prakashlab/inkwell/README.md

# Inkwell
An electricity-free blood-smearing device

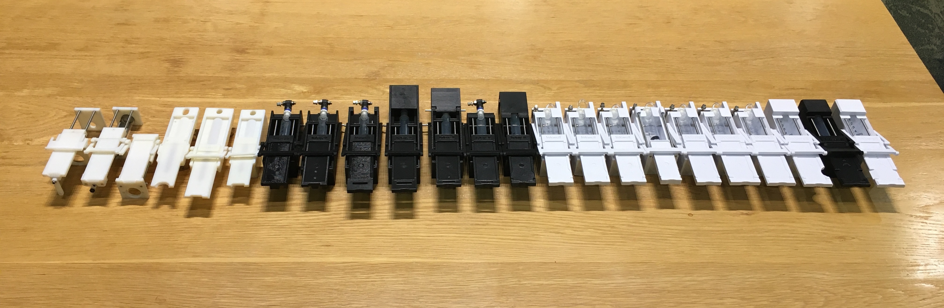
[picture p1: Previous_versions/Family_History_Photos/Inkwell_History_v0.1-v2.8.2.jpeg]
Inkwell History from v0.1 to v2.8.2


The CAD files for the latest version of Inkwell can be found under the Inkwell_v*** folder in the parent directory. All parts should be printed on an FDM machine without support material and oriented as shown in the accompanying screenshots.
