prakashlab/inkwell/Inkwell_v2.9.5/3D_printing_files/Correct Parts Orientation Front.png

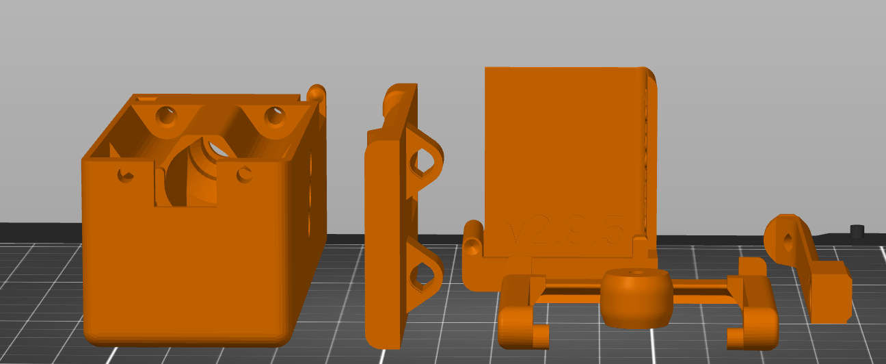
Inkwell_v2.9.5/3D_printing_files/Correct Parts Orientation Front.png
