prakashlab/inkwell/Inkwell_v2.9.5/3D_printing_files/Individual_STL_Parts/Main Body.stl

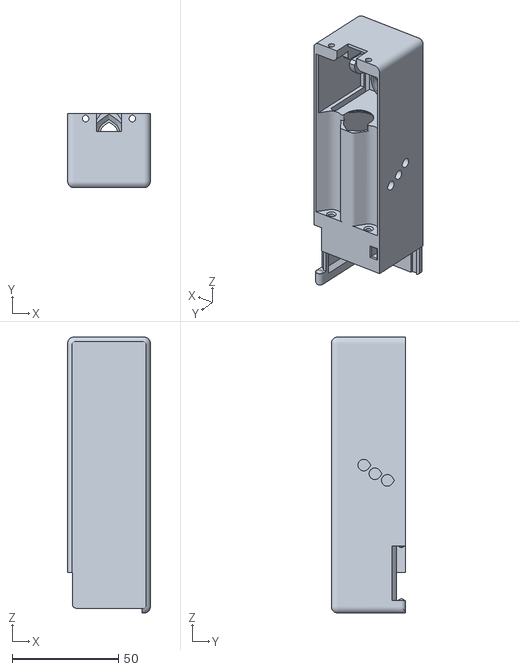
[picture p5: CAD file, 2025-02-18]
Inkwell_v2.9.5/3D_printing_files/Individual_STL_Parts/Main Body.stl
39.0 x 35.0 x 130.0
