prakashlab/inkwell/Inkwell_v2.9.5/3D_printing_files/3MF_and_G-code_files_for_Prusa_i3_MK3S/1x Inkwell v2.9.5.3mf

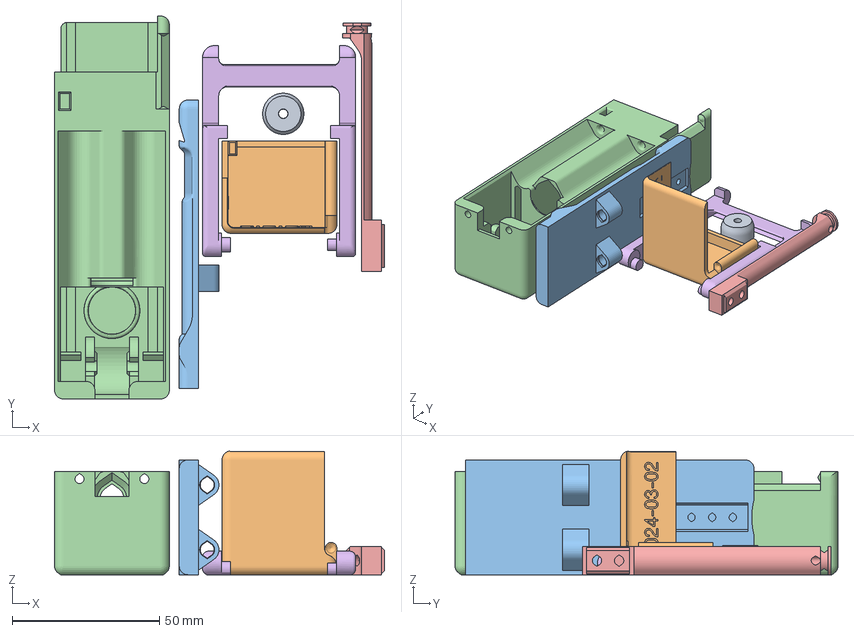
[picture p6: CAD file, 2025-02-18]
Inkwell_v2.9.5/3D_printing_files/3MF_and_G-code_files_for_Prusa_i3_MK3S/1x Inkwell v2.9.5.3mf
112.0 x 130.0 x 41.9 mm
Spool.stl
Back Cover.stl
Carriage.stl
Main Body.stl
Plunger v2.8.2.stl
Spreader Holder.stl
