prakashlab/inkwell/Inkwell_v2.9.5/3D_printing_files/Individual_STL_Parts/Plunger.stl

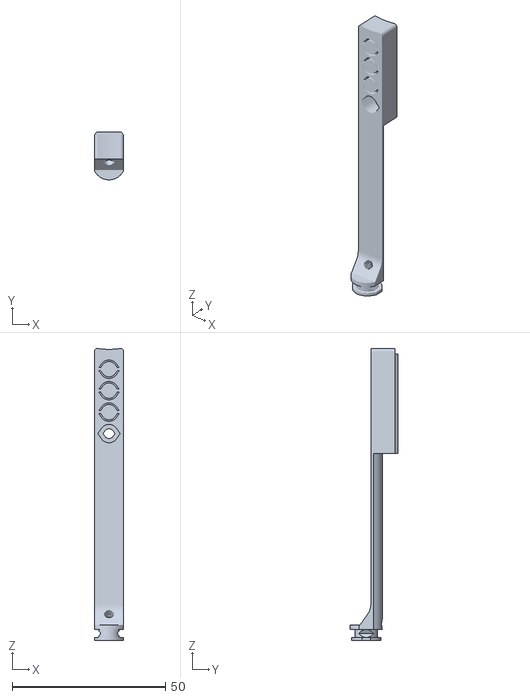
[picture p7: CAD file, 2025-02-18]
Inkwell_v2.9.5/3D_printing_files/Individual_STL_Parts/Plunger.stl
9.60 x 15.5 x 95.1
