prakashlab/inkwell/Inkwell_v2.9.5/3D_printing_files/Individual_STL_Parts/Carriage.stl

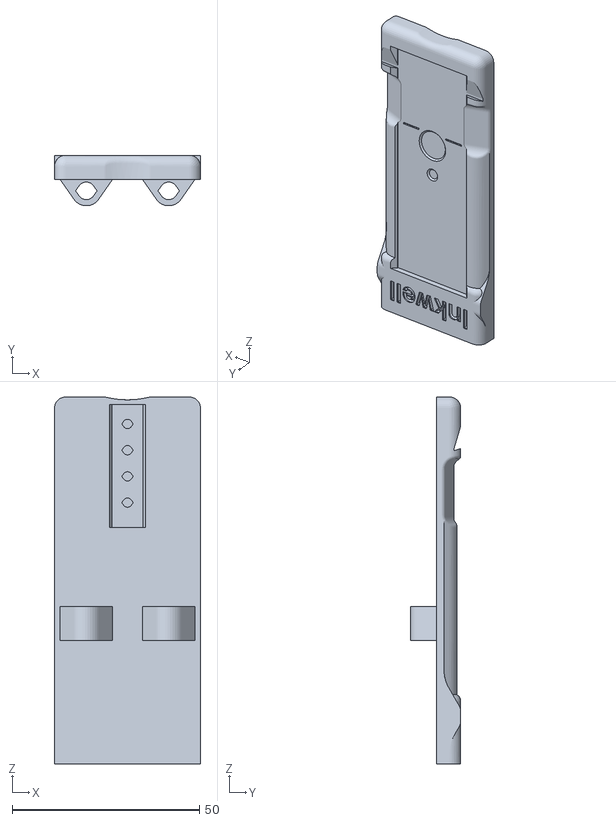
[picture p8: CAD file, 2025-02-18]
Inkwell_v2.9.5/3D_printing_files/Individual_STL_Parts/Carriage.stl
39.0 x 13.5 x 98.0
