prakashlab/inkwell/Inkwell_v2.9.5/3D_printing_files/Individual_STL_Parts/Spool.stl

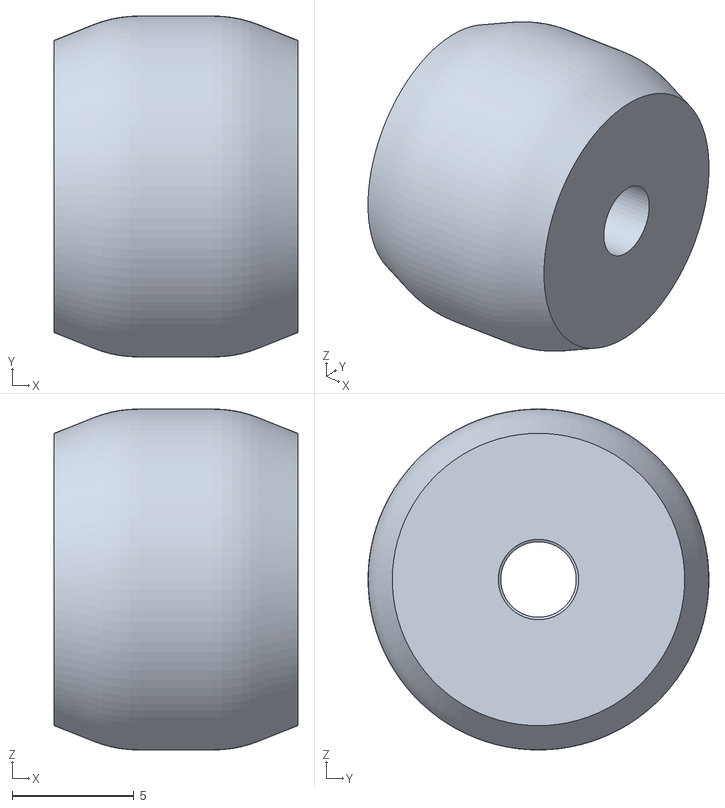
[picture p9: CAD file, 2025-02-18]
Inkwell_v2.9.5/3D_printing_files/Individual_STL_Parts/Spool.stl
10.0 x 14.0 x 14.0
