prakashlab/inkwell/Inkwell_v2.9.5/3D_printing_files/Individual_STL_Parts/Back Cover.stl

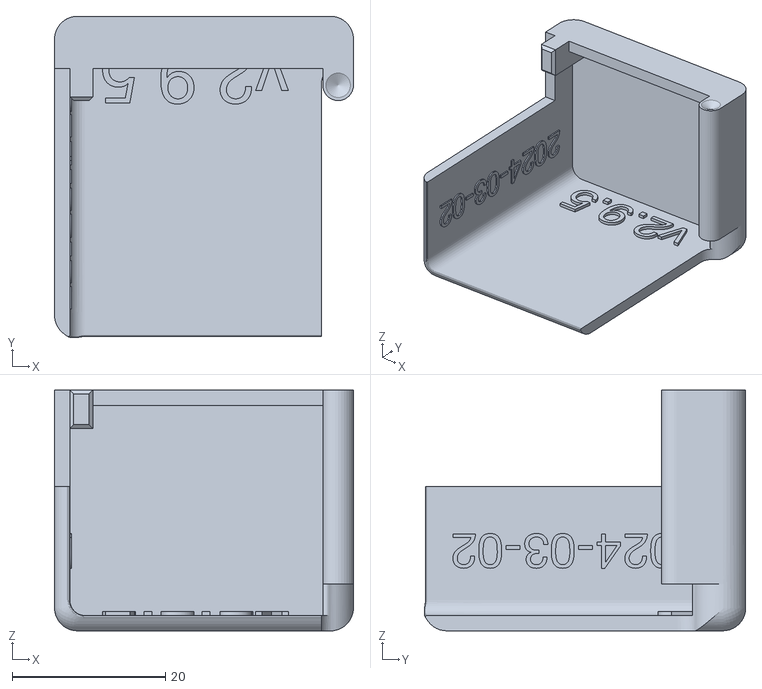
[picture p10: CAD file, 2025-02-18]
Inkwell_v2.9.5/3D_printing_files/Individual_STL_Parts/Back Cover.stl
39.0 x 41.9 x 31.4
