prakashlab/inkwell/Inkwell_v2.9.5/3D_printing_files/Individual_STL_Parts/Spreader Holder.stl

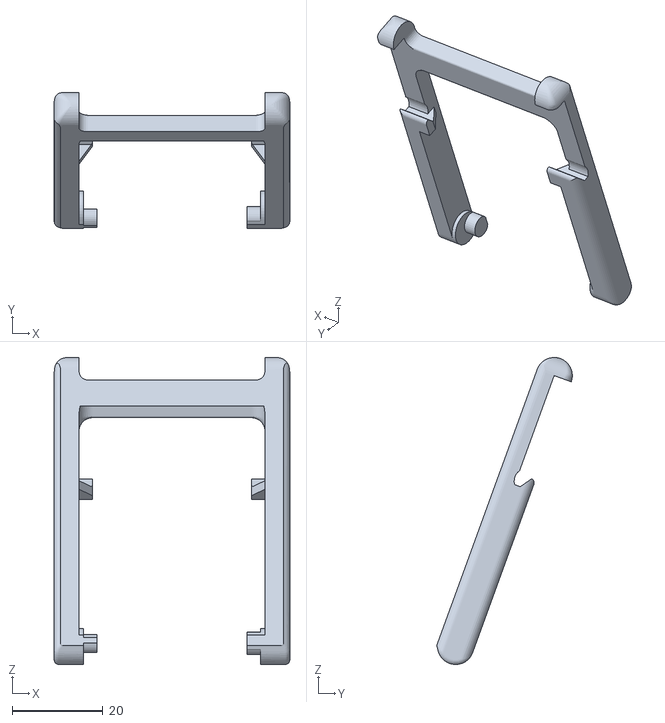
[picture p11: CAD file, 2025-02-18]
Inkwell_v2.9.5/3D_printing_files/Individual_STL_Parts/Spreader Holder.stl
52.0 x 29.9 x 67.8
