prakashlab/inkwell/Previous_versions/Inkwell_v0.3/Main Body.stl

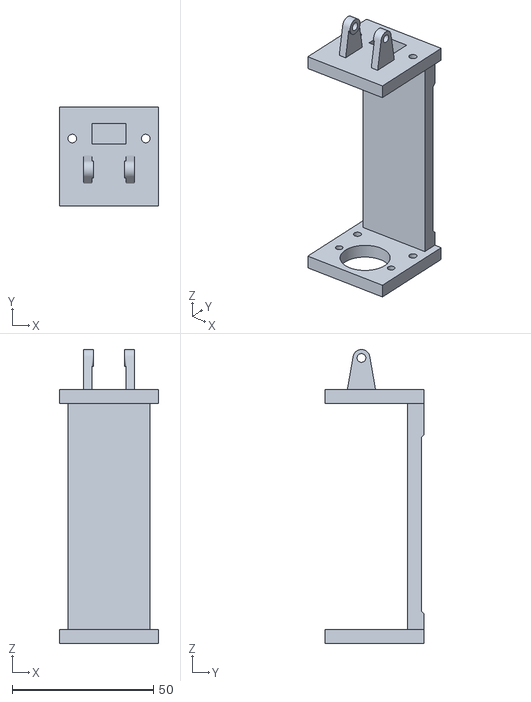
[picture p12: CAD file, 2025-02-18, an earlier design]
Previous_versions/Inkwell_v0.3/Main Body.stl
35.0 x 35.2 x 104.2
