prakashlab/inkwell/Previous_versions/Inkwell_v2.3.1/Main Body.stl

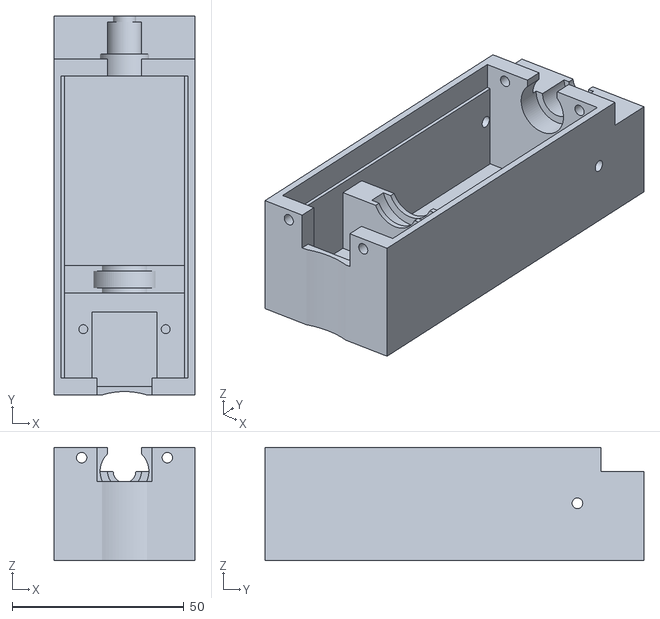
[picture p13: CAD file, 2023-05-05, an earlier design]
Previous_versions/Inkwell_v2.3.1/Main Body.stl
41.0 x 110.5 x 33.0
