prakashlab/inkwell/Previous_versions/Inkwell_v2.7.1/Main Body.stl

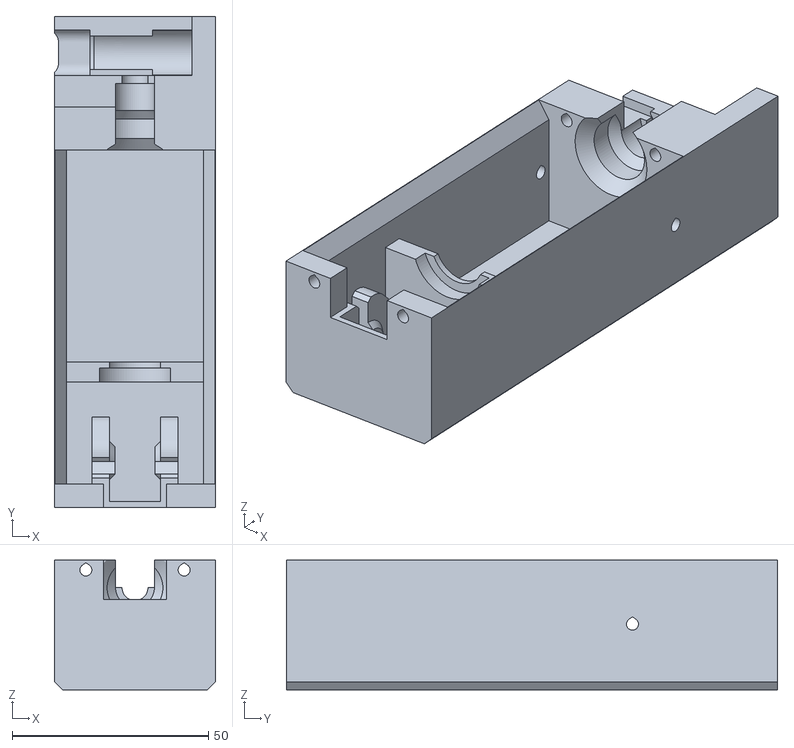
[picture p14: CAD file, 2023-05-05, an earlier design]
Previous_versions/Inkwell_v2.7.1/Main Body.stl
41.0 x 125.0 x 33.0
