prakashlab/inkwell/Previous_versions/Inkwell_v2.7.2/Main Body.stl

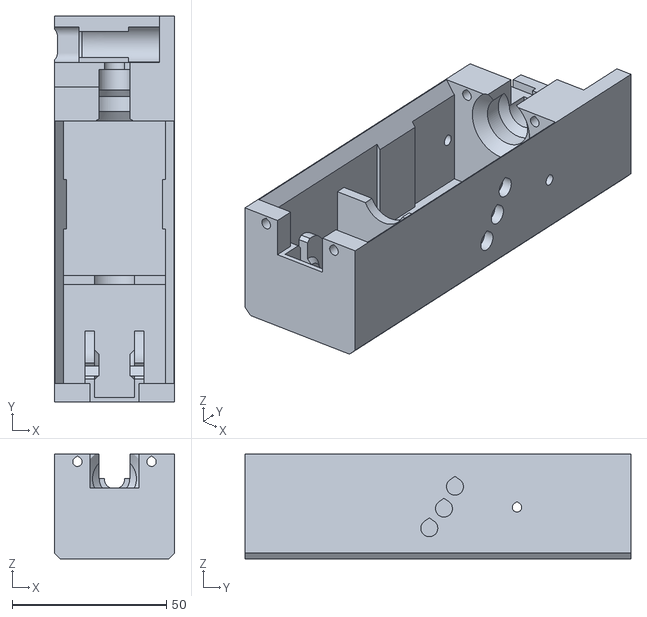
[picture p15: CAD file, 2023-05-05, an earlier design]
Previous_versions/Inkwell_v2.7.2/Main Body.stl
39.0 x 125.0 x 34.0
