prakashlab/inkwell/Inkwell_v2.8.2/STEP_files_for_CAD_modeling/Main Body.step

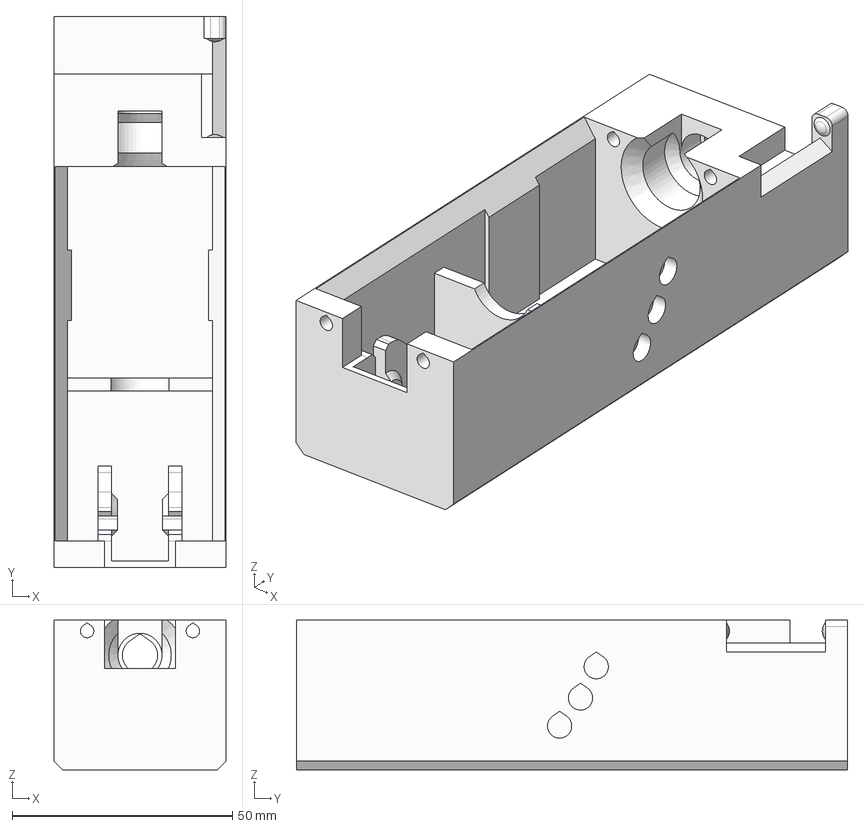
[picture p16: CAD file, 2023-05-05, an earlier design]
Inkwell_v2.8.2/STEP_files_for_CAD_modeling/Main Body.step
39.0 x 125.0 x 34.0 mm
