prakashlab/inkwell/Previous_versions/Inkwell_v2.5.2/Main Body.stl

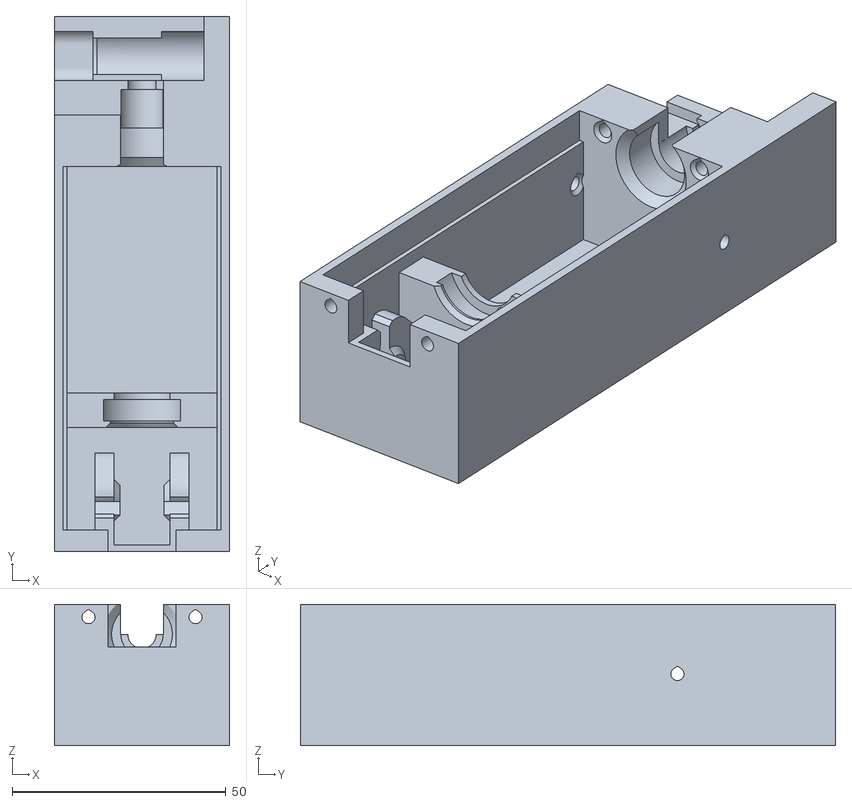
[picture p17: CAD file, 2023-05-05, an earlier design]
Previous_versions/Inkwell_v2.5.2/Main Body.stl
41.0 x 125.0 x 33.0
