prakashlab/inkwell/Previous_versions/Inkwell_v2.6/Main Body.stl

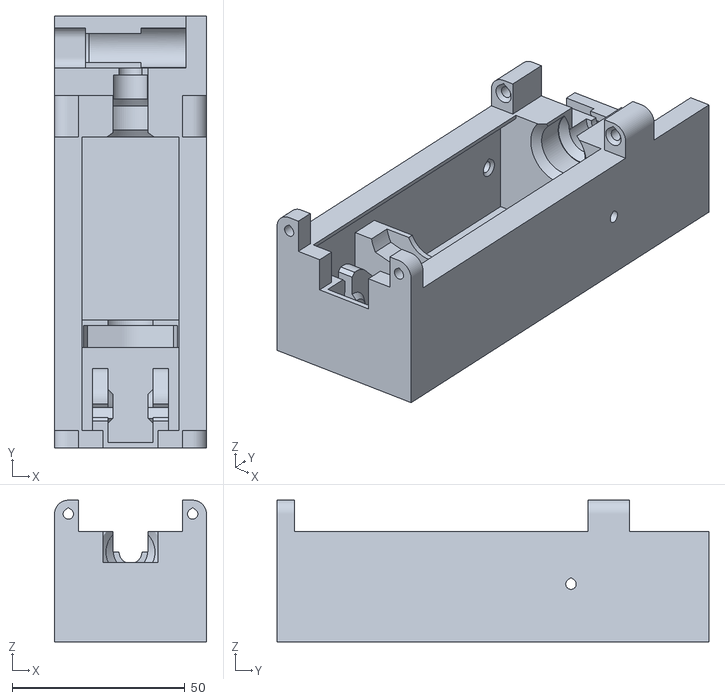
[picture p18: CAD file, 2023-05-05, an earlier design]
Previous_versions/Inkwell_v2.6/Main Body.stl
44.0 x 125.0 x 41.0
