prakashlab/inkwell/(list of files, cad)

Other CAD files:
Inkwell_v2.9.5/3D_printing_files/Inkwell v2.9.5 all parts.stl
Previous_versions/Inkwell_v2.9.2/Main Body.stl
Previous_versions/Inkwell_v2.9.4/Main Body.stl
Inkwell_v2.8.2/STEP_files_for_CAD_modeling/Back Cover.step
Inkwell_v2.8.2/STEP_files_for_CAD_modeling/Carriage.step
Inkwell_v2.8.2/STEP_files_for_CAD_modeling/Inkwell v2.8.2 Assembly.step
Inkwell_v2.8.2/STEP_files_for_CAD_modeling/Plunger.step
Inkwell_v2.8.2/STEP_files_for_CAD_modeling/Spreader Holder.step
Inkwell_v2.8.2/STEP_files_for_CAD_modeling/Spring Spool.step
Inkwell_v2.8.2/STL_files_for_3D_printing/3MF_and_G-code_files_for_Prusa_i3_MK3S/4x Inkwell v2.8.2.3mf
Inkwell_v2.8.2/STL_files_for_3D_printing/3MF_and_G-code_files_for_Prusa_i3_MK3S/Inkwell v2.8.2.3mf
Inkwell_v2.8.2/STL_files_for_3D_printing/Individual STL Parts/Back Cover.stl
Inkwell_v2.8.2/STL_files_for_3D_printing/Individual STL Parts/Cariage.stl
Inkwell_v2.8.2/STL_files_for_3D_printing/Individual STL Parts/Main Body.stl
Inkwell_v2.8.2/STL_files_for_3D_printing/Individual STL Parts/Plunger.stl
Inkwell_v2.8.2/STL_files_for_3D_printing/Individual STL Parts/Spreader Holder.stl
Inkwell_v2.8.2/STL_files_for_3D_printing/Individual STL Parts/Spring Spool.stl
Inkwell_v2.8.2/STL_files_for_3D_printing/Inkwell v2.8.2 all parts x 4.stl
Inkwell_v2.8.2/STL_files_for_3D_printing/Inkwell v2.8.2 all parts.stl
Other_documentation/Motorised_smearing_device/Motorised assembly for microscope.f3z
Previous_versions/Inkwell_v0.1/BackPlate.stl
Previous_versions/Inkwell_v0.1/DashpotBeam.stl
Previous_versions/Inkwell_v0.1/FrontPlate.stl
Previous_versions/Inkwell_v0.1/Inkwell_v0.1.f3z
Previous_versions/Inkwell_v0.1/Shuttle.stl
Previous_versions/Inkwell_v0.1/Spool.stl
Previous_versions/Inkwell_v0.1/SpreaderHolder2.stl
Previous_versions/Inkwell_v0.2/BackPlate.stl
Previous_versions/Inkwell_v0.2/Beam.stl
Previous_versions/Inkwell_v0.2/FrontPlate.stl
Previous_versions/Inkwell_v0.2/Inkwell_v0.2.f3z
Previous_versions/Inkwell_v0.2/Schlage Plug Follower.stl
Previous_versions/Inkwell_v0.2/Shuttle.stl
Previous_versions/Inkwell_v0.3/Inkwell_v0.3.f3z
Previous_versions/Inkwell_v0.3/Spool.stl
Previous_versions/Inkwell_v0.3/Spreader Holder.stl
Previous_versions/Inkwell_v1.0/Base.stl
Previous_versions/Inkwell_v1.0/Shuttle.stl
Previous_versions/Inkwell_v1.0/Skirt.stl
Previous_versions/Inkwell_v1.0/SpringMount.stl
Previous_versions/Inkwell_v1.0/SpringSpool.stl
Previous_versions/Inkwell_v1.0/SyringeClipRigid.stl
Previous_versions/Inkwell_v1.0/SyringeClipSlide.stl
Previous_versions/Inkwell_v1.0/SyringePlunger.stl
Previous_versions/Inkwell_v1.1/Base.stl
Previous_versions/Inkwell_v1.1/Shuttle.stl
Previous_versions/Inkwell_v1.1/SlideHolder.stl
Previous_versions/Inkwell_v1.1/SlideHolderMountLeft.stl
Previous_versions/Inkwell_v1.1/SlideHolderMountRight.stl
Previous_versions/Inkwell_v1.1/SpreaderHolder2-1.stl
Previous_versions/Inkwell_v1.1/SpreaderHolder2.stl
Previous_versions/Inkwell_v1.1/SpreaderHolder3.stl
Previous_versions/Inkwell_v1.1/SpreaderHolder4.stl
Previous_versions/Inkwell_v1.1/SpreaderHolderMount2.stl
Previous_versions/Inkwell_v1.1/SyringeClipRigid.stl
Previous_versions/Inkwell_v1.1/SyringePlunger.stl
Previous_versions/Inkwell_v1.2/Base.stl
Previous_versions/Inkwell_v1.2/Latch.stl
Previous_versions/Inkwell_v1.2/Shuttle.stl
Previous_versions/Inkwell_v1.2/Skirt.stl
Previous_versions/Inkwell_v1.2/SpreaderHolder2.stl
Previous_versions/Inkwell_v1.2/SpringMount.stl
Previous_versions/Inkwell_v1.2/SpringSpool.stl
Previous_versions/Inkwell_v1.2/SyringeClipRigid.stl
Previous_versions/Inkwell_v1.2/SyringeClipSlide.stl
Previous_versions/Inkwell_v1.2/SyringePlunger.stl
Previous_versions/Inkwell_v1.2/ValveBody.stl
Previous_versions/Inkwell_v1.2/ValvePlunger-2.65.stl
Previous_versions/Inkwell_v1.2/ValvePlunger-2.70.stl
Previous_versions/Inkwell_v1.2/ValvePlunger-2.75.stl
Previous_versions/Inkwell_v1.2/ValveThumbScrew.stl
Previous_versions/Inkwell_v2.3.0/Cariage.stl
Previous_versions/Inkwell_v2.3.0/Inkwell v2.3.0.3mf
Previous_versions/Inkwell_v2.3.0/Main Body.stl
Previous_versions/Inkwell_v2.3.0/Plunger.stl
Previous_versions/Inkwell_v2.3.0/Spreader Holder.stl
Previous_versions/Inkwell_v2.3.0/Spring Mount.stl
Previous_versions/Inkwell_v2.3.0/Spring Spool.stl
Previous_versions/Inkwell_v2.3.1/Cariage.stl
Previous_versions/Inkwell_v2.3.1/Inkwell v2.3.1 custom supports.3mf
Previous_versions/Inkwell_v2.3.1/Plunger.stl
Previous_versions/Inkwell_v2.3.1/Plunger10mm.stl
Previous_versions/Inkwell_v2.3.1/Spreader Holder.stl
Previous_versions/Inkwell_v2.3.1/Spring Mount.stl
Previous_versions/Inkwell_v2.3.1/Spring Spool.stl
Previous_versions/Inkwell_v2.4/2022-10-26 Inkwell v2-4.3mf
Previous_versions/Inkwell_v2.4/Back Cover New.stl
Previous_versions/Inkwell_v2.4/Back Cover.stl
Previous_versions/Inkwell_v2.4/Cariage.stl
Previous_versions/Inkwell_v2.4/Custom Support Test.3mf
Previous_versions/Inkwell_v2.4/Main Body.stl
Previous_versions/Inkwell_v2.4/Plunger.stl
Previous_versions/Inkwell_v2.4/Spreader Holder.stl
Previous_versions/Inkwell_v2.4/Spring Mount Clip.stl
Previous_versions/Inkwell_v2.4/Spring Mount.stl
Previous_versions/Inkwell_v2.4/Spring Spool.stl
Previous_versions/Inkwell_v2.5.0/2022-10-27 Inkwell v2.5.0.3mf
Previous_versions/Inkwell_v2.5.0/2022-10-27 Test 2x Inkwell v2.5.0.3mf
Previous_versions/Inkwell_v2.5.0/Cariage.stl
Previous_versions/Inkwell_v2.5.0/Main Body.stl
Previous_versions/Inkwell_v2.5.0/Plunger.stl
Previous_versions/Inkwell_v2.5.0/Spreader Holder.stl
Previous_versions/Inkwell_v2.5.0/Spring Spool.stl
Previous_versions/Inkwell_v2.5.1/2022-10-28 Inkwell v2.5.1 test no support.3mf
Previous_versions/Inkwell_v2.5.1/2022-10-28 Inkwell v2.5.1.3mf
Previous_versions/Inkwell_v2.5.1/Cariage.stl
Previous_versions/Inkwell_v2.5.1/Main Body.stl
Previous_versions/Inkwell_v2.5.1/Plunger.stl
Previous_versions/Inkwell_v2.5.1/Spreader Holder.stl
Previous_versions/Inkwell_v2.5.1/Spring Spool.stl
Previous_versions/Inkwell_v2.5.2/2022-11-03 Inkwell v2.5.2.3mf
Previous_versions/Inkwell_v2.5.2/Cariage.stl
Previous_versions/Inkwell_v2.5.2/Plunger.stl
Previous_versions/Inkwell_v2.5.2/Spreader Holder.stl
Previous_versions/Inkwell_v2.5.2/Spring Spool.stl
Previous_versions/Inkwell_v2.6/2022-11-05 Inkwell v2.6.3mf
Previous_versions/Inkwell_v2.6/Cariage v2.stl
Previous_versions/Inkwell_v2.6/Plunger.stl
Previous_versions/Inkwell_v2.6/Spreader Holder.stl
Previous_versions/Inkwell_v2.6/Spring Spool.stl
Previous_versions/Inkwell_v2.7.0/2022-11-06 Inkwell v2.7.0 2.3mf
Previous_versions/Inkwell_v2.7.0/2022-11-06 Inkwell v2.7.0.3mf
Previous_versions/Inkwell_v2.7.0/Cariage.stl
Previous_versions/Inkwell_v2.7.0/Main Body.stl
Previous_versions/Inkwell_v2.7.0/Plunger.stl
Previous_versions/Inkwell_v2.7.0/Spreader Holder.stl
Previous_versions/Inkwell_v2.7.0/Spring Spool.stl
Previous_versions/Inkwell_v2.7.1/2022-11-07 Inkwell v2.7.1.3mf
Previous_versions/Inkwell_v2.7.1/Cariage.stl
Previous_versions/Inkwell_v2.7.1/Plunger.stl
Previous_versions/Inkwell_v2.7.1/Spreader Holder.stl
Previous_versions/Inkwell_v2.7.1/Spring Spool.stl
Previous_versions/Inkwell_v2.7.2/2022-11-09 Inkwell v2.7.2.3mf
Previous_versions/Inkwell_v2.7.2/Cariage.stl
Previous_versions/Inkwell_v2.7.2/Plunger.stl
Previous_versions/Inkwell_v2.7.2/Spreader Holder.stl
Previous_versions/Inkwell_v2.7.2/Spring Spool.stl
Previous_versions/Inkwell_v2.8.0/2022-11-10 Inkwell v2.8.0.3mf
Previous_versions/Inkwell_v2.8.0/Back Cover.stl
Previous_versions/Inkwell_v2.8.0/Cariage.stl
Previous_versions/Inkwell_v2.8.0/Main Body.stl
Previous_versions/Inkwell_v2.8.0/Plunger.stl
Previous_versions/Inkwell_v2.8.0/Spreader Holder.stl
Previous_versions/Inkwell_v2.8.0/Spring Spool.stl
Previous_versions/Inkwell_v2.8.1/2022-11-11 Inkwell v2.8.1.3mf
Previous_versions/Inkwell_v2.8.1/Back Cover.stl
Previous_versions/Inkwell_v2.8.1/Cariage.stl
Previous_versions/Inkwell_v2.8.1/Main Body.stl
Previous_versions/Inkwell_v2.8.1/Plunger.stl
Previous_versions/Inkwell_v2.8.1/Spreader Holder.stl
Previous_versions/Inkwell_v2.8.1/Spring Spool.stl
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
