prakashlab/inkwell/(commit log)

2023-05-01 Add 3D print v2.8 file
    [Inkwell v2.8 v146.stl]
2023-05-05 Add CAD files for v2.8.2 and previous versions, delete deprecated fabrication directory
    [2022-10-26 Inkwell v2-4.3mf, 2022-10-27 Inkwell v2.5.0.3mf, 2022-10-27 Test 2x Inkwell v2.5.0.3mf, 2022-10-28 Inkwell v2.5.1 test no support.3mf, 2022-10-28 Inkwell v2.5.1.3mf, 2022-11-03 Inkwell v2.5.2.3mf, 2022-11-05 Inkwell v2.6.3mf, 2022-11-06 Inkwell v2.7.0 2.3mf]
2025-02-18 Add Fusion 360 source files for versions 2.8.2 and 2.9.5, add CAD exports for older versions, add family history photos
    [1x Inkwell v2.9.5.3mf, 4x Inkwell v2.8.2.3mf, Back Cover.step, Back Cover.stl, BackPlate.stl, Base.stl, Beam.stl, Cariage.stl]
2025-02-18 Update README and CREDITS, add CAD files for previous versions and for the motorised smearing machine.
    [Cariage.stl, Inkwell v.3.1.3mf, Inkwell v2.3.0.3mf, Inkwell v2.3.1 custom supports.3mf, Inkwell_v0.1.f3z, Inkwell_v0.2.f3z, Inkwell_v0.3.f3z, Main Body.stl]
